averywallis/Feather-SAM-M8Q-GPS/README.md

# Feather-SAM-M8Q-GPS
 KiCad files for a SAM-M8Q GPS Featherwing
