averywallis/Feather-SAM-M8Q-GPS/V1-SAM-M8Q-GPS/bottom-normal-view.png

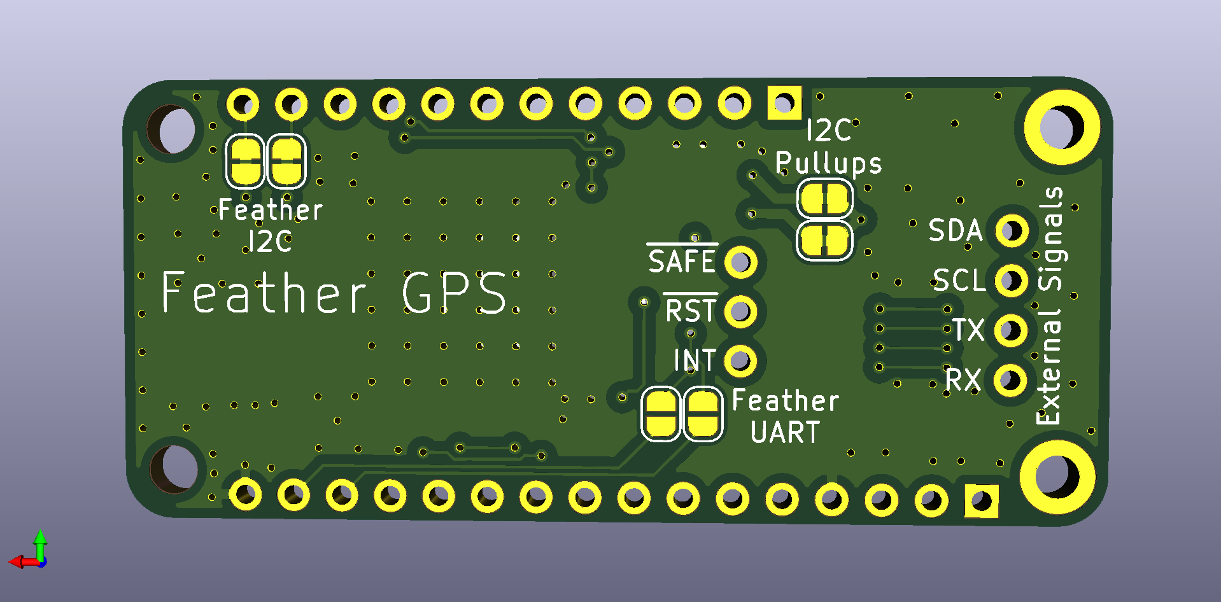
V1-SAM-M8Q-GPS/bottom-normal-view.png
