averywallis/Feather-SAM-M8Q-GPS/V1-SAM-M8Q-GPS/bottom-rendered-view.png

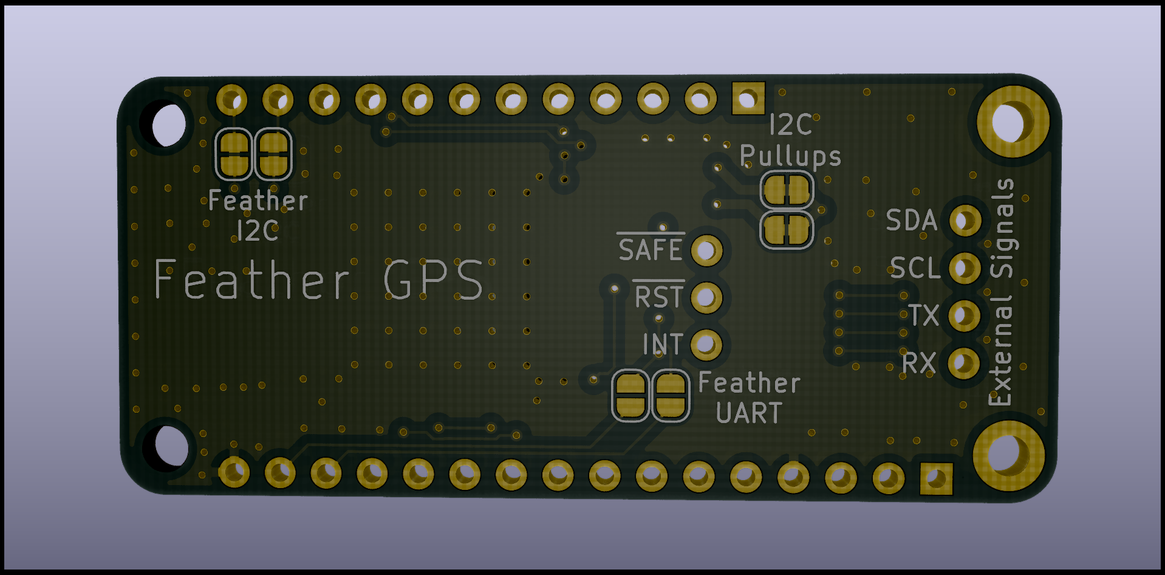
V1-SAM-M8Q-GPS/bottom-rendered-view.png
