averywallis/Feather-SAM-M8Q-GPS/V1-SAM-M8Q-GPS/bottom.JPG

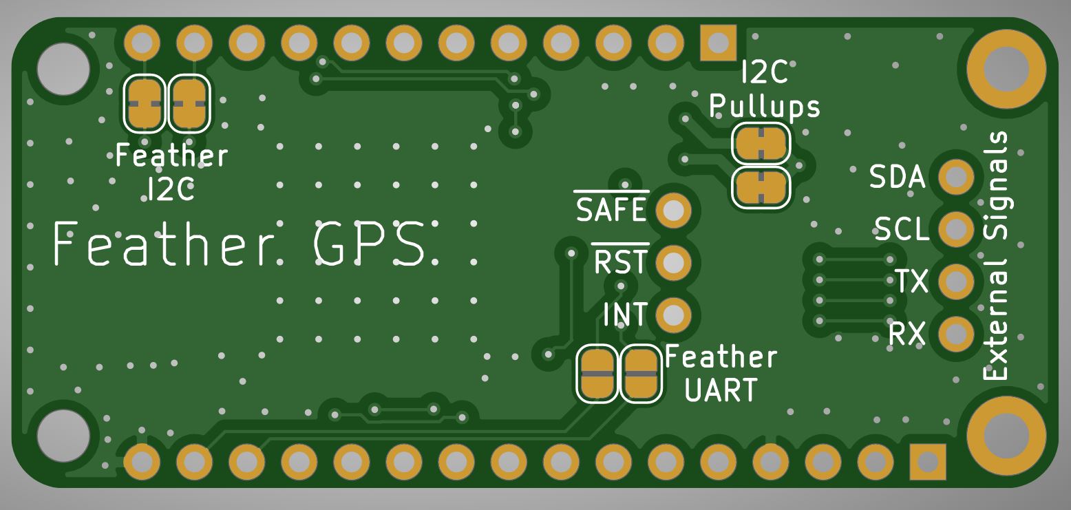
V1-SAM-M8Q-GPS/bottom.JPG
