averywallis/Feather-SAM-M8Q-GPS/V1-SAM-M8Q-GPS/layers.PNG

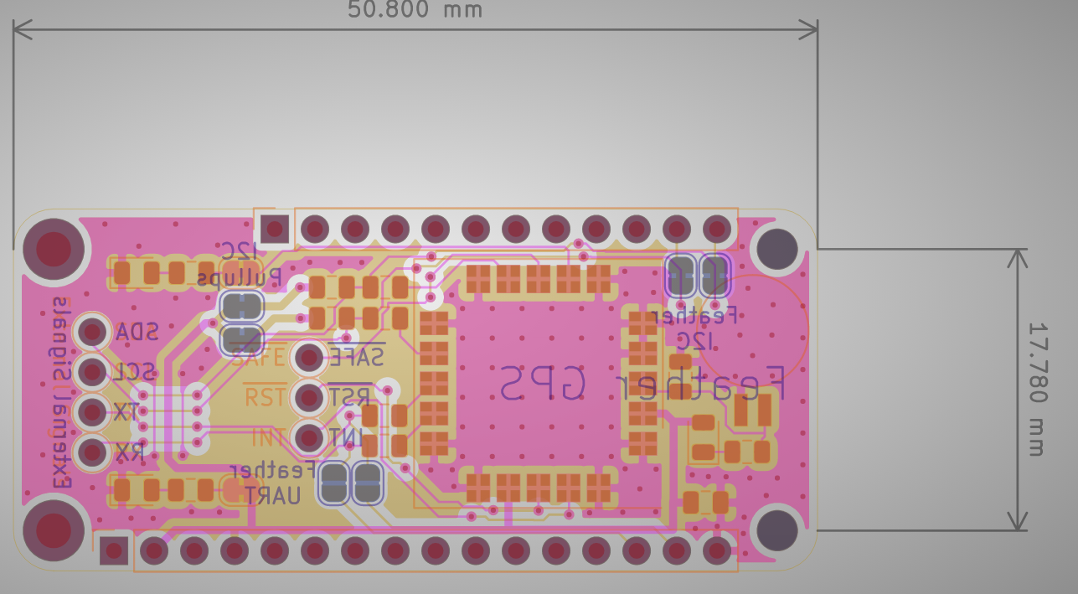
V1-SAM-M8Q-GPS/layers.PNG
