averywallis/Feather-SAM-M8Q-GPS/V1-SAM-M8Q-GPS/Top-normal-view.png

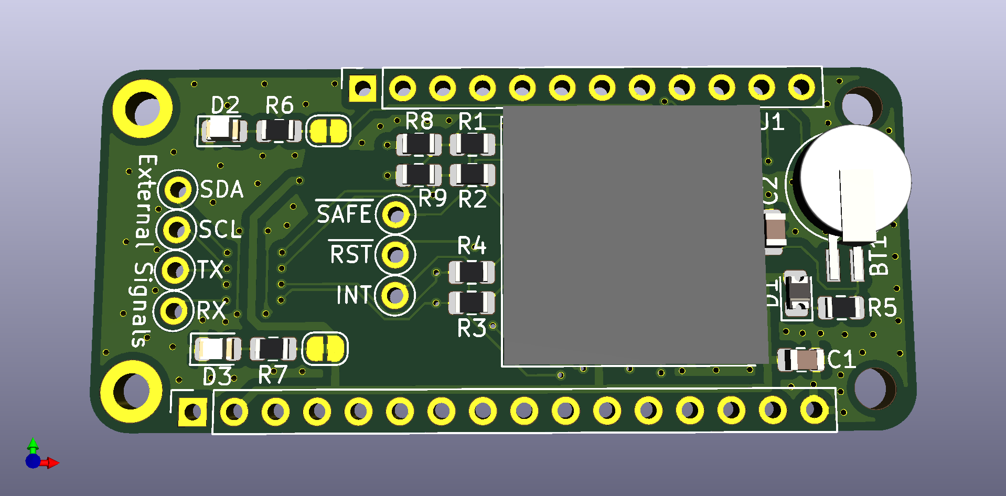
V1-SAM-M8Q-GPS/Top-normal-view.png
