averywallis/Feather-SAM-M8Q-GPS/V2-SAM-M8Q-GPS-Featherwing/bottom.png

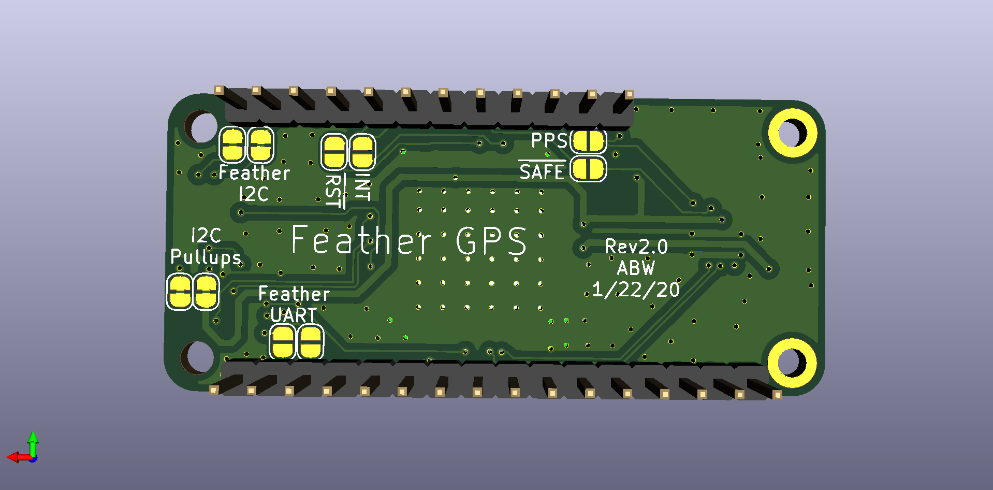
V2-SAM-M8Q-GPS-Featherwing/bottom.png
