averywallis/Feather-SAM-M8Q-GPS/V2-SAM-M8Q-GPS-Featherwing/top-traces.PNG

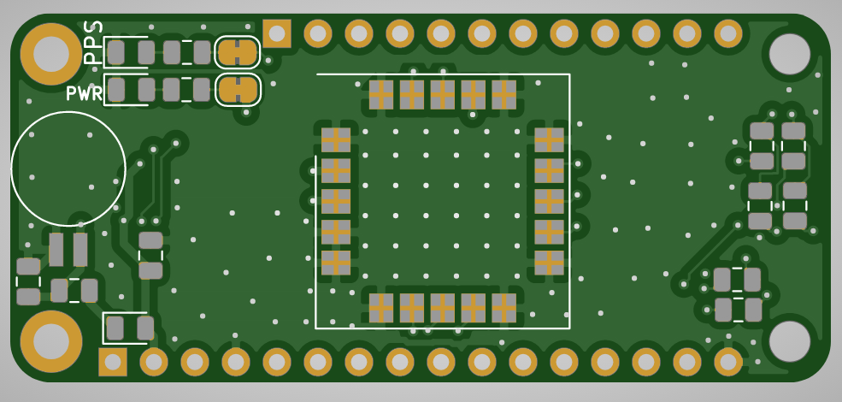
V2-SAM-M8Q-GPS-Featherwing/top-traces.PNG
