averywallis/Feather-SAM-M8Q-GPS/Feather-SAM-M8Q-GPS.kicad_pcb

## KiCad design Feather-SAM-M8Q-GPS.kicad_pcb (2020-01-24)

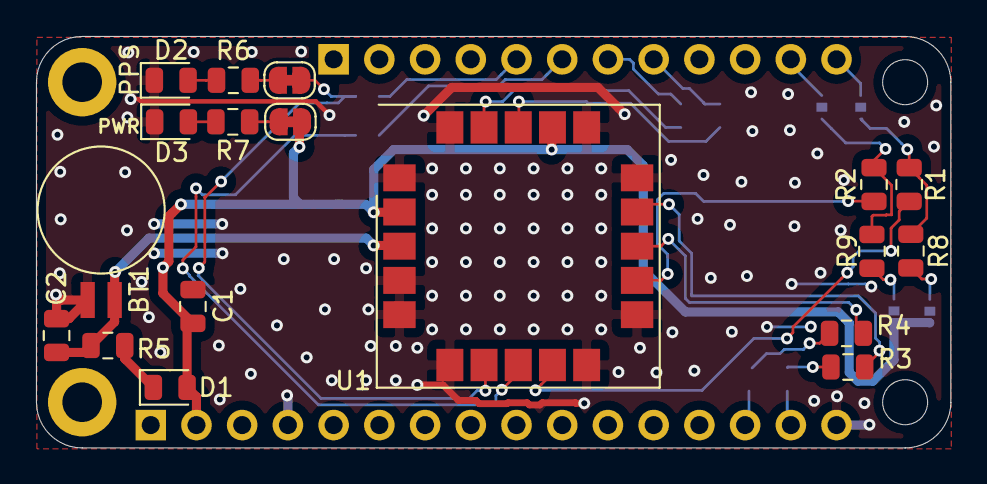
[picture p14: board Feather-SAM-M8Q-GPS.kicad_pcb from above]

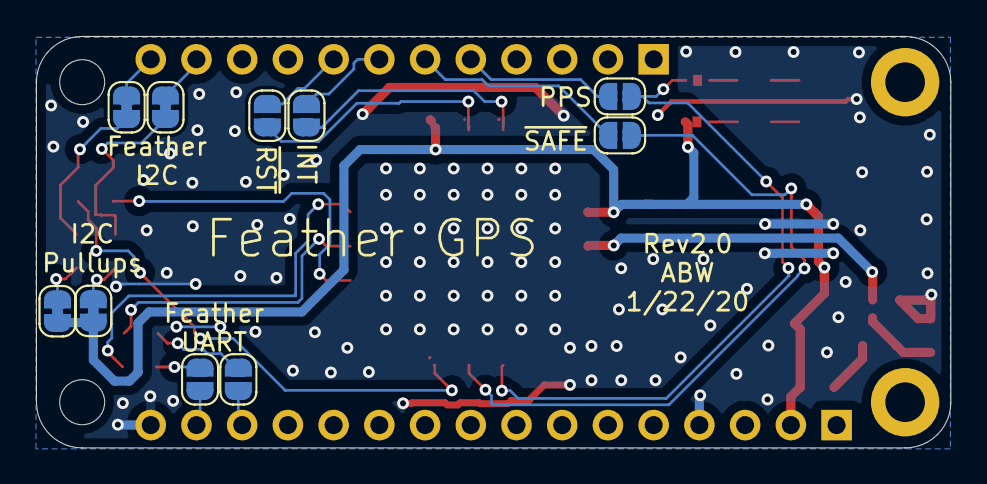
[picture p15: board Feather-SAM-M8Q-GPS.kicad_pcb from below]

Board: 2 copper layers, 50.8 x 22.9 mm, 28 parts (10 on the bottom side), 22 nets.

Parts:
BT1: BatteryHolder_Seiko_MS621F
C1, C2: 1.0uF; C_0805_2012Metric
D1: D_Schottky; D_0805_2012Metric
D2: YELLOW; LED_0805_2012Metric
D3: RED; LED_0805_2012Metric
JP1, JP2, JP3, JP6, JP7, JP8: SolderJumper-2_P1.3mm_Bridged_RoundedPad1.0x1.5mm
JP4, JP5, JP9, JP10, JP11, JP12: SolderJumper-2_P1.3mm_Open_RoundedPad1.0x1.5mm
R1, R2: 22; R_0805_2012Metric
R3, R4: 470; R_0805_2012Metric
R5: 3.3k; R_0805_2012Metric
R6, R7: 1k; R_0805_2012Metric
R8, R9: 2.2k; R_0805_2012Metric
U1: ublox_SAM-M8Q

Connections:
+3V3: C1.1, D1.2, JP2.1, JP3.2, JP6.2, U1.2, U1.17
/BACKUP: BT1.1, C2.1, R5.1, U1.3
/INT: JP10.2, U1.19
/PPS: JP1.1, JP12.2, U1.7
/RX: JP4.1, R3.1
/TX: JP5.1, R4.1
/~RESET: JP11.2, U1.18
/~SAFE: JP9.1, U1.8
GND: BT1.2, C1.2, C2.2, D2.1, D3.1, U1.1, U1.4, U1.5, U1.6, U1.10, U1.11, U1.15, U1.16, U1.20
unnamed: D1.1, R5.2
unnamed: D2.2, R6.1
unnamed: D3.2, R7.1
unnamed: JP1.2, R6.2
unnamed: JP2.2, R7.2
unnamed: JP3.1, R8.1
unnamed: JP6.1, R9.1
unnamed: JP7.1, R1.1, R8.2
unnamed: JP8.1, R2.1, R9.2
unnamed: R1.2, U1.9
unnamed: R2.2, U1.12
unnamed: R3.2, U1.14
unnamed: R4.2, U1.13
